freaf87/FSEDevBoard/README.md

Rpi Autonomous Car PCB 
====================
This board bring those additional functions below to the Raspberry pi:

	 - Analog Digital Converter with MCP3008 (8)
	 - DC Brushed Motor driver (2) with TB6612FNG
	 - Level converted IOs (5V <-> 3.3V) (8)
     - 16-channel, 12-bit PWM with PCA9685
     - RGB LED (1)
     - Pushbutton (1)

Top                                                                      |  Bottom
:-----------------------------------------------------------------------:|:--------------------------------------------------------------:
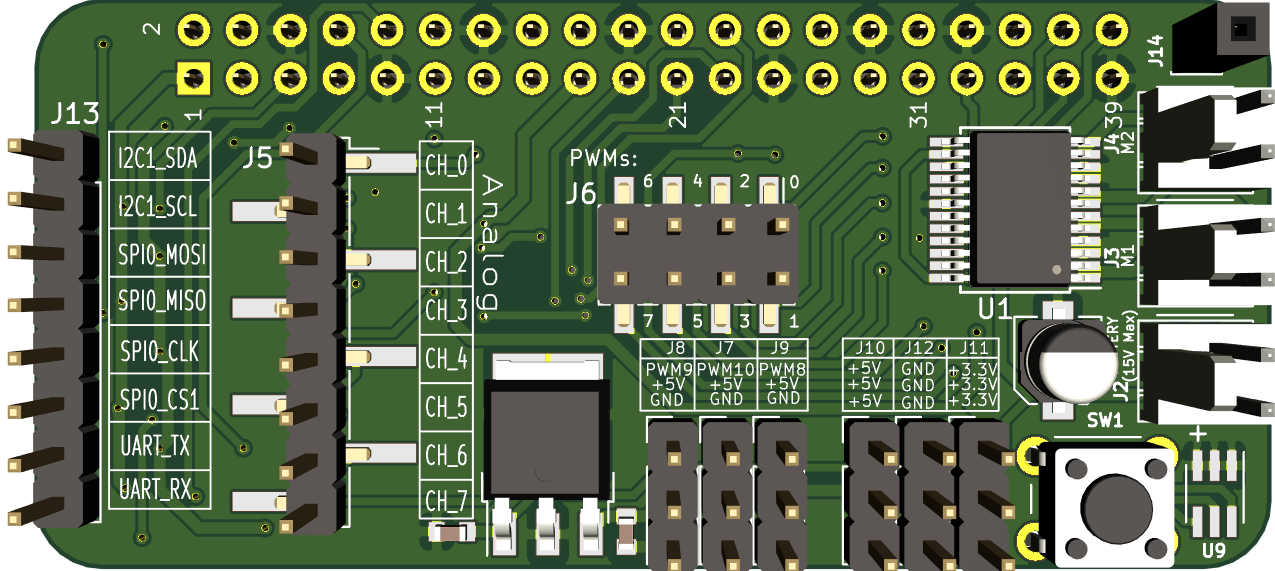
[picture p1: 03_Docs/Documentation/Figures/topView.png]
Top
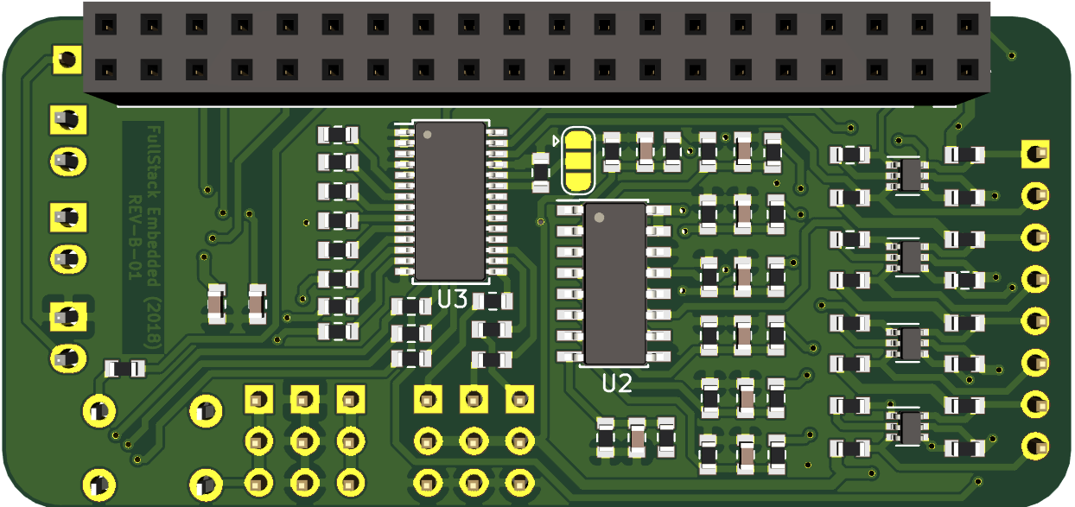
[picture p2: 03_Docs/Documentation/Figures/bottomView.png]
Bottom
  |  

Author: Frederic Afadjigla, 2018
