freaf87/FSEDevBoard/03_Docs/Documentation/FSEDevBoardDoc.pdf

# F S E D E V E L O PM E N T B O A R D

# R E F E R E N C E M A N U A L

frederic afadjigla

Decembre 22, 2018

contents

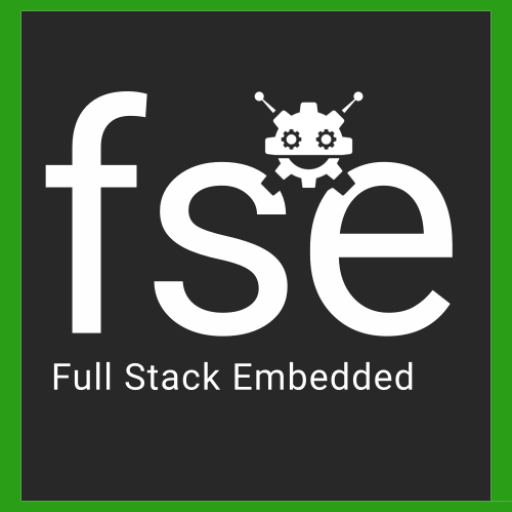
[picture p9: figure]

1 | Introduction | 3
2 | FSEDevBoard and its Components | 3
2.1 | Analog Inputs for Raspberry Pi Using the MCP3008 | | 4
2.2 | Level Converted Pins | | 5
2.3 | DC Motor driver - TB6612FNG | | 6
3 | The Raspberry Pi pinout | 7
Appendices | 8

list of figures

Figure 1 | Top view of board | | 3
Figure 2 | Bottom view of board | | 3
Figure 3 | FSEDevBoard Overview | | 3
Figure 4 | MCP3008 schematic | | 4
Figure 5 | Level Converter | | 5
Figure 6 | TB6612FNG schematic | | 6
Figure 7 | RPiZero | | 8

list of tables

Table 1 | MCP3008 SPI connection | | 4
Table 2 | Level Converted Pins | | 5

1

List of Tables 2

abstract

The purpose of this document is to give the reader an overview about the FSEDevBoard’s hardware. This plattform will be use during FSE workshops. Principal hardware components of the board and interfaces will be briefly described.

introduction | 3
1 | introduction

This breakout board was build with the intention to add some additional features to the Raspberry Pi such as 8 Analog Digital Converter Pins, 2 DC Brushed Motor driver interfaces with TB6612FNG, 8 bidirectional level converted IOs (5V <-> 3.3V), 16-channel 12-bit PWM with PCA9685, one RGB LED and one Pushbutton. The following chapter will bring some light in how to interact with those functionalities.

2 fsedevboard and its components

Top and bottom view of the board are shown in figure 1 and figure 2. Brief Overview of the board can be taken from figure 3. All Jumpers are placed on the top to ease connection with jumper wires. Powering the board and the Pi can done via the micro USB port of the Raspberry Pi or via the Jumper J2. Please make sure not to connect both at the same time or this will destroy both boards. A battery voltage of maximum 15V can be connected to that jumper. This voltage will be used to drive both DC Motors and will be break down to 5V via a linear voltage regulator and provided to the Raspberry Pi.

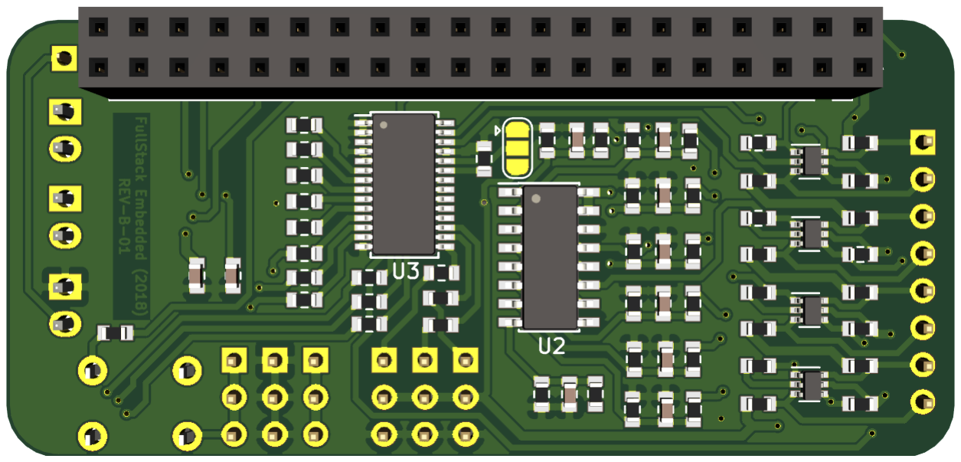
[picture p10: figure]
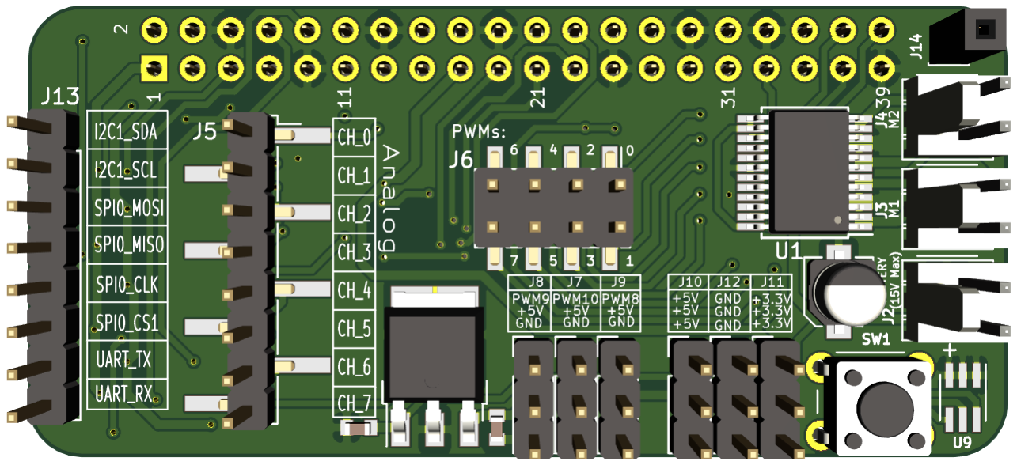
[picture p11: figure]

Figure 1: Top view of board | Figure 2: Bottom view of board

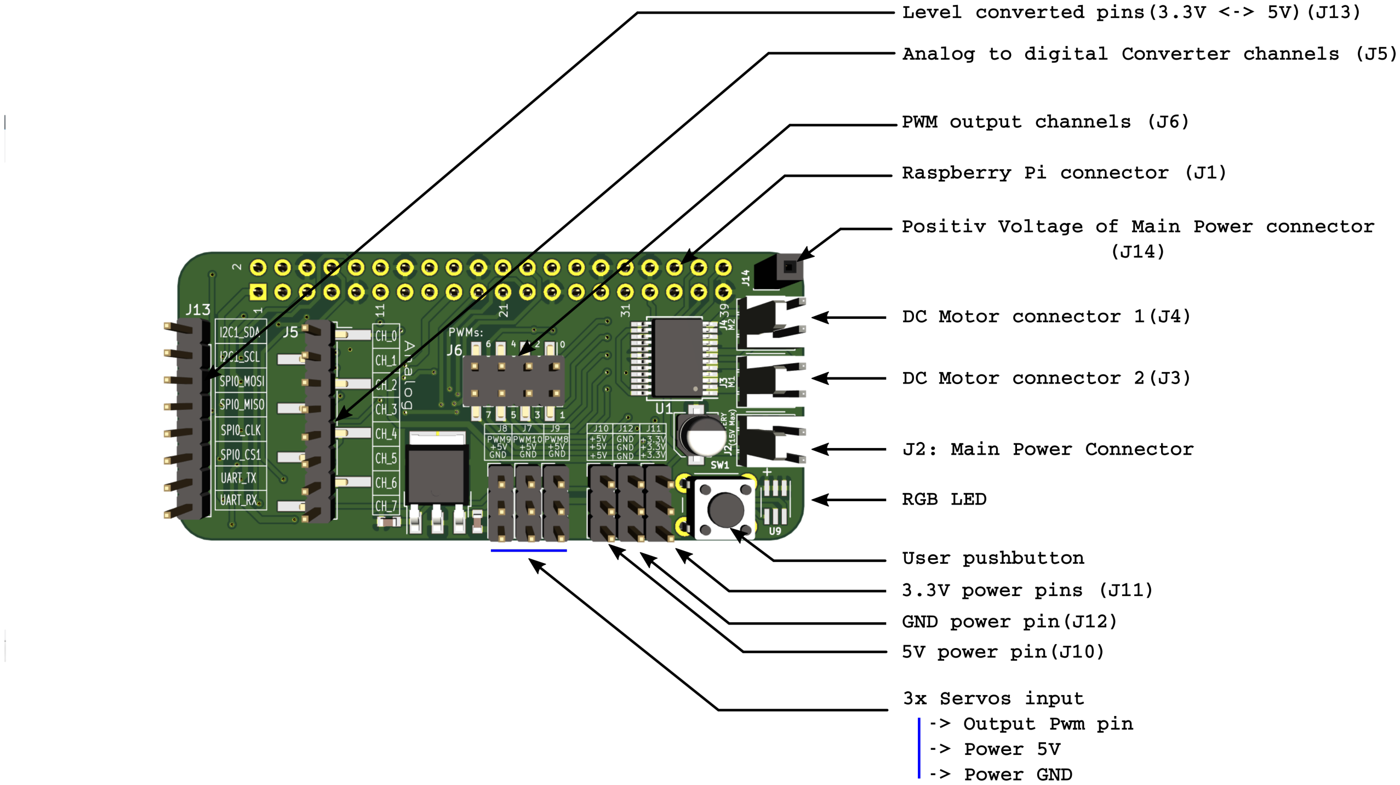
[picture p12: figure]

Figure 3: FSEDevBoard Overview

fsedevboard and its components | 4
2.1 | Analog Inputs for Raspberry Pi Using the MCP3008

The MCP3008 is a low cost 8-channel 10-bit analog to digital converter. The MCP3008 connects to the Raspberry Pi using a serial peripheral interface (SPI) serial connection.

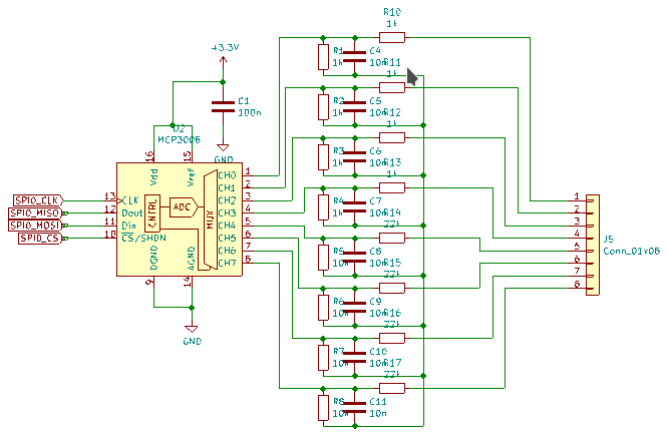
[picture p13: figure]

Figure 4: MCP3008 schematic

SPI Pins | Raspberry Pi pin
SCLK (Serial Clock) | GPIO11
MOSI (Master Out Slave In) | GPIO10
MISO (Master In Slave Out) | GPIO09
CS (Chip Select) | GPIO25

Table 1: MCP3008 SPI connection

Voltage that are allowed to be connected to the MCP3008 have to be selected so that Vout muss be less than 3.3V(Vref). Vout is the voltage that can be measured after the voltage dividers. All 4 first channels (0,1,2 and 3) are designed to have a measuring range of 0-5V DC. The last 4 Channels can measure up to 10V. Vout[0−3]

| for channels 0,1,2 and
3 can be calculated as:

Vout[0−3] =

R6
R5 + R6

∗ Vin = 0.5 ∗ Vin

In case of channel 4,5,6 and 7:

Vout[4−7] = 0.316 ∗ Vin

Jumper J14 can be connected to one of Channel 4 to 7 to measure the batterie voltage of the Board.

fsedevboard and its components | 5
2.2 | Level Converted Pins

Precautions have to be taken when connecting 5V devices to the raspberry pi since the Pi is not 5V tolerant. The user has to make sure that voltage going to the Raspberry Pi do not exceed 5V. There are many ways to handle the matter. Easiest way is probably using voltage dividers with 2 resistors. Care has to be taken to the direction of the voltage since those are not bidirectional. More robust way which gives you biderctional capacity is by using an Integrated circuit (IC) or using the circuitry like I did in figure 5 based on one N-Channel Mosfet.

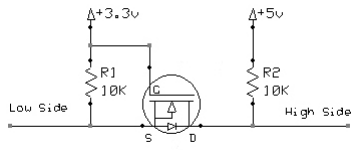
[picture p14: figure]

Figure 5: Level Converter 1

Low Side Control: When the low side (3.3V) device transmits a ’1’ (3.3V), the MOSFET is tied high (off), and the high side sees 5V through the R2 pull-up resistor. When the low side transmits a ’0’ (0V), the MOSFET source pin is grounded and the MOSFET is switched on and the high side is pulled down to 0V.²
High Side Control: When the high side transmits a ’0’ (0V) the MOSFET substrate diode conducts pulling the lowside down to approx 0.7V, this is also low enough to turn the MOSFET on, further pulling the low side down. When the high side transmits a ’1’ (5V) the MOSFET source pin is pulled up to 3.3V and the MOSFET is OFF.
Note This works with I2C and other open collector type gates 3
Pins | RPi pin
1 | GPIO02
2 | GPIO03
3 | GPIO10
4 | GPIO09
5 | GPIO011
6 | GPIO07
7 | GPIO14
8 | GPIO15

Table 2: Level Converted Pins

1 http://www.hobbytronics.co.uk/mosfet-voltage-level-converter
2 see footnote 1
3 see footnote 1

fsedevboard and its components | 6
2.3 | DC Motor driver - TB6612FNG

The TB6612FNG motor driver can control up to two DC motors at a constant current of 1.2A (3.2A peak). Two input signals (IN1 and IN2) can be used to control the motor in one of four function modes - clockwise (CW), counter-clockwise (CCW), short-brake, and stop. The two motor outputs (A and B) can be separately controlled, the speed of each motor is controlled via a PWM input signal with a frequency up to 100kHz. The STBY pin should be pulled high to take the motor out of standby mode.
Logic supply voltage (VCC) can be in the range of 2.7-5.5VDC, while the motor supply (VM) is limited to a maximum voltage of 15VDC. The output current is rated up to 1.2A per channel (or up to 3.2A for a short, single pulse).

Features:
- Power supply voltage: VM=15V max, VCC=2.7-5.5V
- Output current: Iout=1.2A(average) / 3.2A (peak)
- Standby control to save power
- CW/CCW/short brake/stop motor control modes
- Built-in thermal shutdown circuit and low voltage detecting circuit
- All pins of the TB6612FNG broken out to 0.1" spaced pins
- Filtering capacitors on both supply lines


Figure 6: TB6612FNG schematic

the raspberry pi pinout | 7

Let’s discuss the pinout for the TB6612FNG:

Pin Label | Function | Notes
VM | Motor Voltage | This is where you provide power for the motors (2.2V to
13.5V)
VCC | Logic Voltage | This is the voltage to power the chip and talk to the micro-
controller (2.7V to 5.5V)
GND | Ground | Common Ground for both motor voltage and logic voltage
(all GND pins are connected)
STBY | Standby | Allows the H-bridges to work when high (has a pulldown
resistor so it must actively pulled high)
AIN1/BIN1 | Input 1 for channels A/B | One of the two inputs that determines the direction
AIN2/BIN2 | Input 2 for channels A/B | One of the two inputs that determines the direction
PWMA/PWMB | PWM input for channels
A/B

PWM input that controls the speed

A01/B01 | Output 1 for channels A/B | One of the two outputs to connect the motor
A02/B02 | Output 2 for channels A/B | One of the two outputs to connect the motor

Table 3: TB6612FNG connection

When the outputs are set to High/Low your motor will run. When they are set to Low/High the motor will run in the opposite direction. In both cases, the speed is controlled by the PWM input.

In1 | In2 | PWM | Out1 | Out2 | Mode
H | H | H/L | L | L | Short brake
L | H | H | L | H | CCW
L | H | L | L | L | Short brake
H | L | H | H | L | CW
H | L | L | L | L | Short brake
L | L | H | OFF | OFF | Stop

Table 4: TB6612FNG Logic

3 the raspberry pi pinout

The Raspberry Pi is a credit card-sized minicomputer with a pre-installed Linux system. As for ports, the Raspberry Pi provides ports for mouse and keyboard. In addition, there are also ports for SD card and HDMI display. Being low cost and low consumption, the Raspberry Pi is very suitable to do very complicated embedded projects through its powerful GPIO (General-purpose input/output) pins. The Raspberry Pi’s GPIOs can be accessed over a standard male header on the board. Over the years the header expanded from 26 to 40 pins.There are 2 different numbering schemes you may encounter when referencing Pi pin numbers: (1) Broadcom chip-specific pin numbers and (2) P1 physical pin numbers. You’re usually free to use either number-system, but many programs require that you declare which scheme you’re using at the very beginning of your program. The Official name of a GPIO pin normally matches BCM pin number. For example, Physical Pin 7 (described in Table 5 ’s column Pin Nbr) official name is GPIO 04 , in BCM system is pin# 4.
Green areas in Table 5 are representing free GPIOs which are not connected to anything on the FSEDevBoard. Therefore, you can safely add some new connections to those pins

8

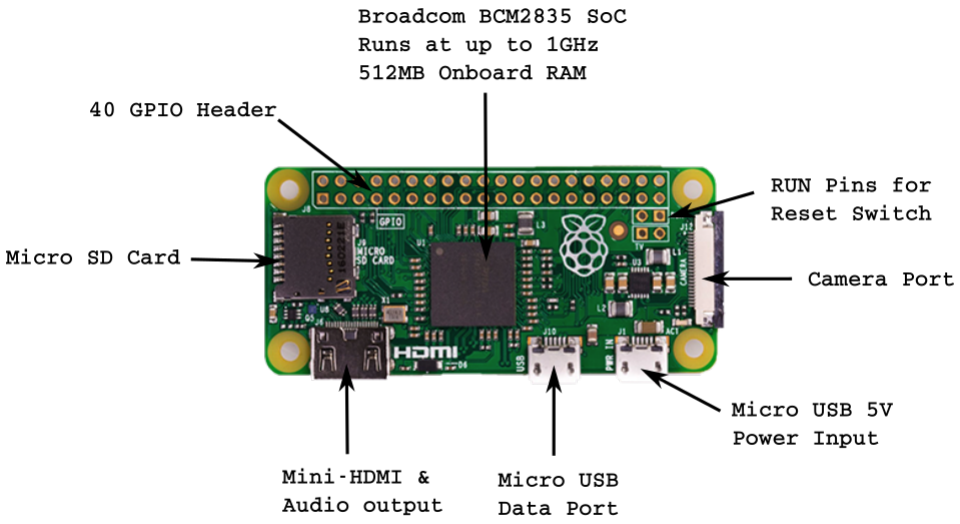
[picture p15: figure]

Figure 7: RPiZero

FSEDevBoard | Name | Pin Nbr | Name | FSEDevBoard
| 3V3 | 1 | 2 | 5V
LV I2C1 SDA | GPIO02 (SDA1, I2C) | 3 | 4 | 5V
LV I2C1 SCL | GPIO03 (SCL1, I2C) | 5 | 6 | GND
| GPIO04 (GPIO_GCLK) | 7 | 8 | GPIO14 (TXD0) | LV UART TX
| GND | 9 | 10 | GPIO15 (RXD0) | LV UART RX
| GPIO17 (GPIO_GEN0) | 11 | 12 | GPIO18 (GPIO_GEN1)
| GPIO27 (GPIO_GEN2) | 13 | 14 | GND
| GPIO22 (GPIO_GEN3) | 15 | 16 | GPIO23 (GPIO_GEN4)
| 3V3 | 17 | 18 | GPIO24 (GPIO_GEN5)
LV SPI0 MOSI | GPIO10 (SPI_MOSI) | 19 | 20 | GND
LV SPI0 MISO | GPIO09 (SPI_MISO) | 21 | 22 | GPIO25 (GPIO_GEN6) | Push button
LV SPI0 CLK | GPIO11 (SPI_CLK) | 23 | 24 | GPIO08 (SPI_CE0_N) | MCP3008 SPI0 CS
| GND | 25 | 26 | GPIO07 (SPI_CE1_N) | LV SPI0 CS1 (J13_6)
| ID_SD (I2C ID EEPROM) | 27 | 28 | ID_SC (I2C ID EEPROM)
| GPIO05 | 29 | 30 | GND
| GPIO06 | 31 | 32 | GPIO12 | TB6612FNG PWMA
TB6612FNG PWMB | GPIO13 | 33 | 34 | GND
TB6612FNG AIN1 | GPIO19 | 35 | 36 | GPIO16 | TB6612FNG AIN2
TB6612FNG BIN1 | GPIO26 | 37 | 38 | GPIO20 | TB6612FNG BIN2
| GND | 39 | 40 | GPIO21 | TB6612FNG STBY

Table 5: Raspberry Pi Pinout

# Appendices

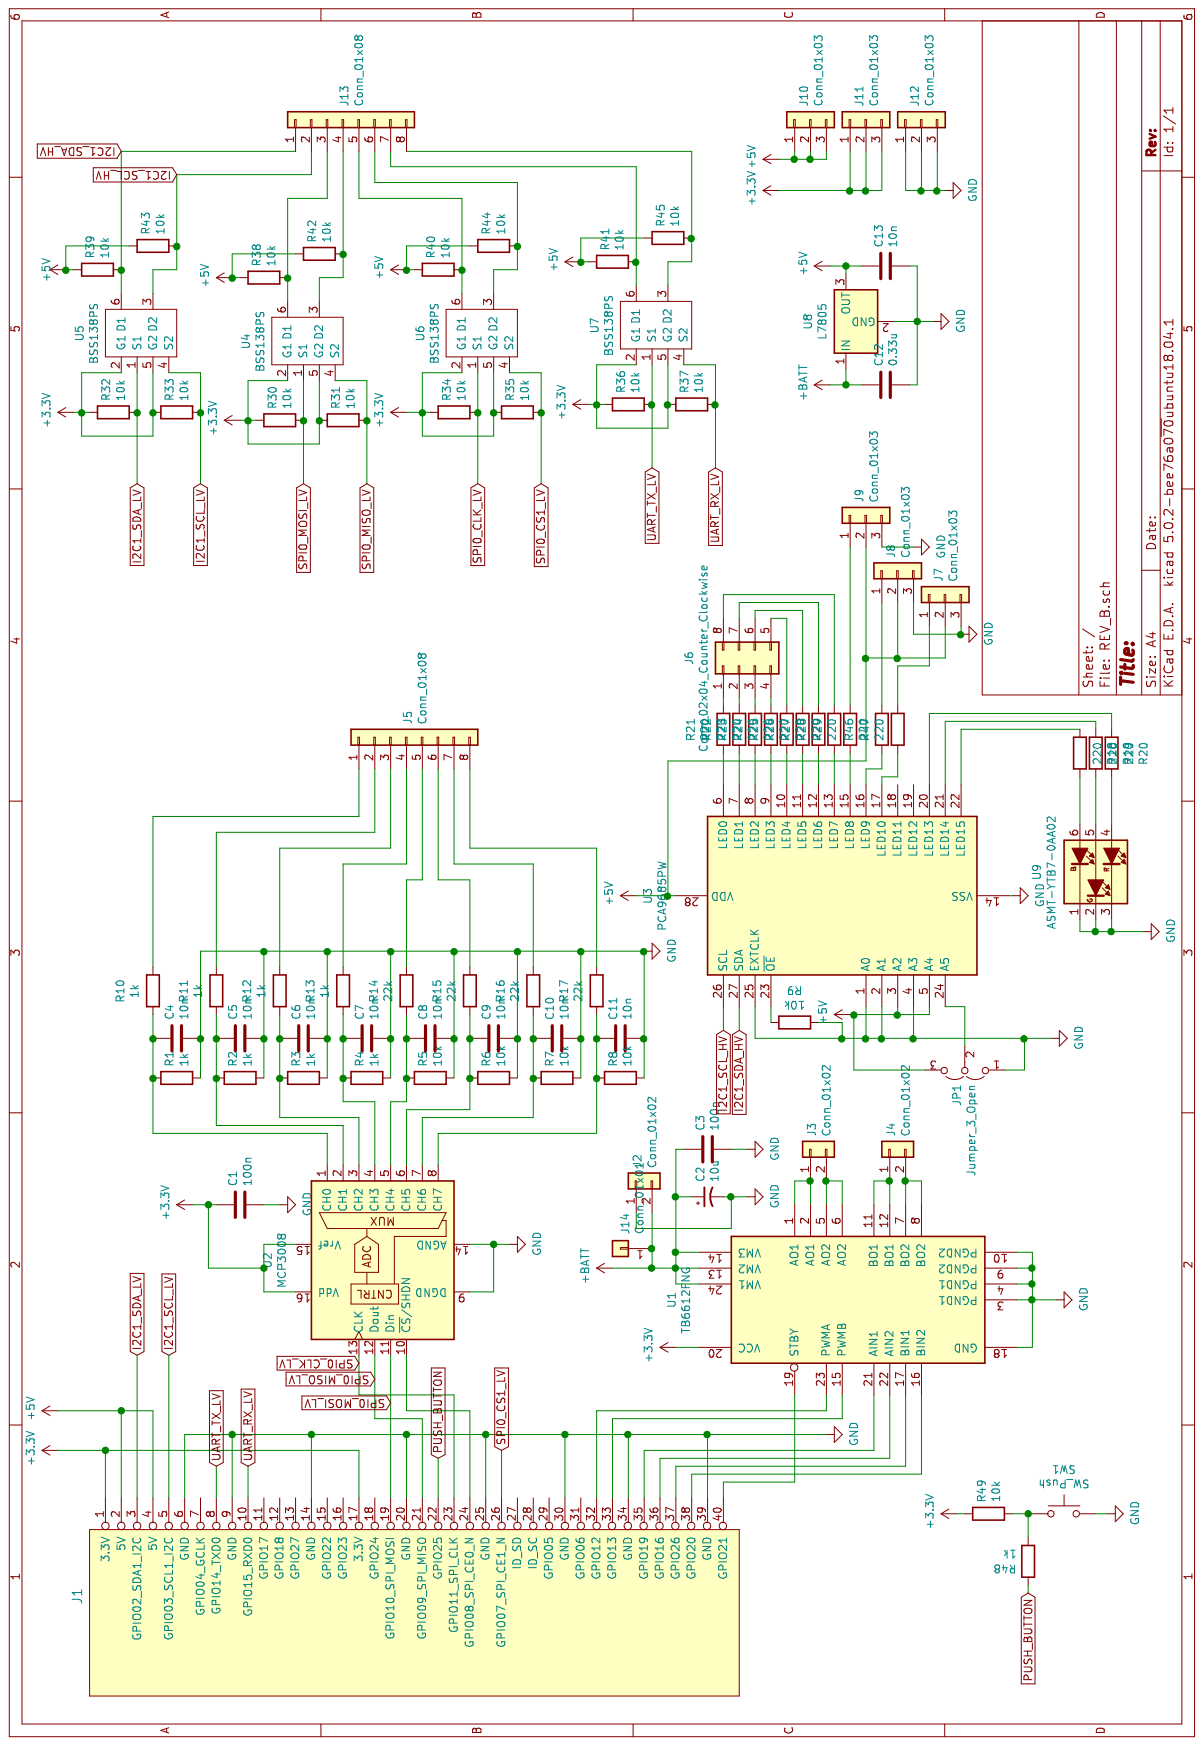
[picture p16: page 9]
