freaf87/FSEDevBoard/03_Docs/Documentation/Figures/LevelConverter.png

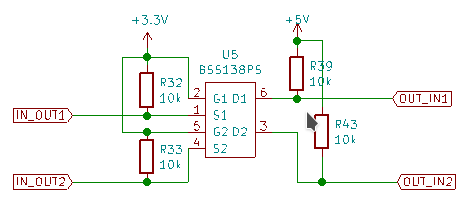
03_Docs/Documentation/Figures/LevelConverter.png
