freaf87/FSEDevBoard/03_Docs/Documentation/Figures/PCA9685.png

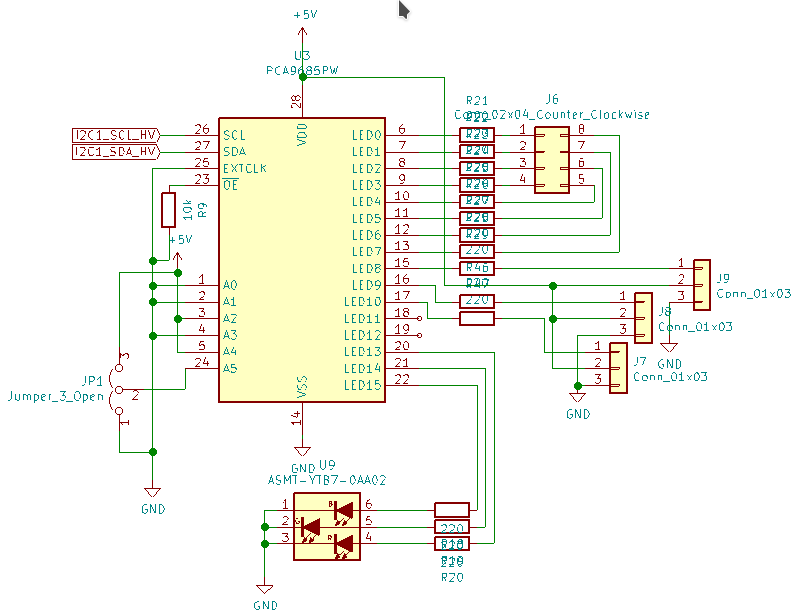
03_Docs/Documentation/Figures/PCA9685.png
