freaf87/FSEDevBoard/03_Docs/Documentation/Figures/PushButton.png

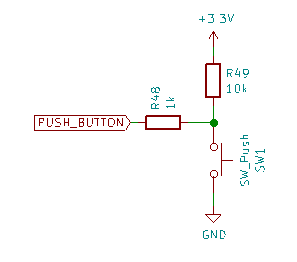
03_Docs/Documentation/Figures/PushButton.png
