freaf87/FSEDevBoard/03_Docs/Documentation/Figures/RaspberryPiZero.png

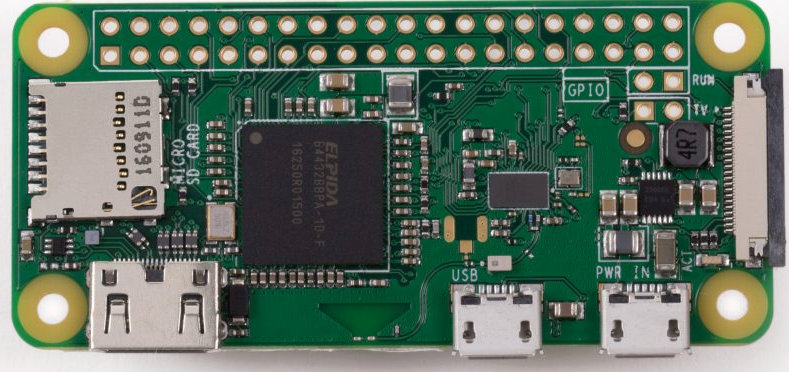
03_Docs/Documentation/Figures/RaspberryPiZero.png
