freaf87/FSEDevBoard/04_Order/REV_B_Order.ods

Sheet: ORDER
DATE: 12.12.2018
DIGIKEY ORDER
 | Pos | Menge | Teilenummer | Hersteller-Teilenummer | Beschreibung | Kundenreferenz | Stückpreis | Gesamtpreis EUR
 | 1 | 1 | 516-3132-1-ND | ASMT-YTB7-0AA02 | LED RGB DIFFUSED 6PLCC SMD | U9 | 1,17000 | 1,17
 | 2 | 2 | 1276-1012-1-ND | CL10F104ZB8NNNC | CAP CER 0.1UF 50V Y5V 0603 | C1, C3 | 0,09000 | 0,18
 | 3 | 1 | PCE3878CT-ND | EEE-1CA100SR | CAP ALUM 10UF 20% 16V SMD | C2 | 0,27000 | 0,27
 | 4 | 10 | 478-9371-1-ND | 06031C103K4T2A | CAP CER 10000PF 100V X7R 0603 | C4, C5, C6, C7, C8, C9, C10, C11, C13 | 0,08700 | 0,87
 | 5 | 1 | 311-2081-1-ND | CC0603KRX7R7BB334 | CAP CER 0.33UF 16V X7R 0603 | C12 | 0,18000 | 0,18
 | 6 | 1 | S1013EC-16-ND | NREC016SABC-M30RC | CONN HEADER .100" SNGL SMD 16POS |  | 0,47000 | 0,47
 | 7 | 1 | 952-3158-ND | M20-8750442 | CONN HDR .100" SMD 8POS |  | 0,56000 | 0,56
 | 8 | 10 | RR08P1.0KDCT-ND | RR0816P-102-D | RES SMD 1K OHM 0.5% 1/16W 0603 | R1, R2, R3, R4, R10, R11, R12, R13, R48 | 0,08600 | 0,86
 | 9 | 25 | RR08P10.0KDCT-ND | RR0816P-103-D | RES SMD 10K OHM 0.5% 1/16W 0603 | R5, R6, R7, R8, R9, R30, R31, R32, R33, R34, R35 | 0,08600 | 2,15
 | 10 | 5 | RHM22KDCT-ND | ESR03EZPJ223 | RES SMD 22K OHM 5% 1/4W 0603 | R14, R15, R16, R17 | 0,09000 | 0,45
 | 11 | 15 | RHM220DCT-ND | ESR03EZPJ221 | RES SMD 220 OHM 5% 1/4W 0603 | R18, R19, R20, R21, R22, R23, R24, R25, R26, R27 | 0,07600 | 1,14
 | 12 | 1 | 450-1650-ND | 1825910-6 | SWITCH TACTILE SPST-NO 0.05A 24V | SW1 | 0,09000 | 0,09
 | 13 | 1 | TB6612FNGC8ELCT-ND | TB6612FNG,C,8,EL | IC MOTOR DRIVER PAR 24SSOP | U1 | 1,85000 | 1,85
 | 14 | 1 | MCP3008T-I/SLCT-ND | MCP3008T-I/SL | IC ADC 10BIT 2.7V 8CH SPI 16SOIC | U2 | 1,98000 | 1,98
 | 15 | 1 | 568-8366-5-ND | PCA9685PW,112 | IC LED DRVR LIN DIM 25MA 28TSSOP | U3 | 1,98000 | 1,98
 | 16 | 4 | 1727-6478-1-ND | BSS138BKS,115 | MOSFET 2N-CH 60V 0.32A 6TSSOP | U4, U5, U6, U7 | 0,44000 | 1,76
 | 17 | 1 | 497-7255-1-ND | L7805CDT-TR | IC REG LINEAR 5V 1.5A DPAK | U8 | 0,66000 | 0,66
REICHELT ORDER

Sheet: Sheet2
 | www.digikey.com
 | www.reichelt.de
 | Description | References | Value | Quantity | Prize | Total | Link
1 | Unpolarized capacitor | C12 | 0.33u | 1 | 0.1 | 0.1 | 311-2081-1-ND
2 | Unpolarized capacitor | C1 C3 | 100n | 2 | 0.132 | 0.264 | 445-12576-1-ND
3 | Unpolarized capacitor | C4 C5 C6 C7 C8 C9 C10 C11 C13 | 10n | 9 | 0.058 | 0.522 | 445-5662-1-ND
4 | Polarised capacitor | C2 | 10u | 1 | 0.24 | 0.24 | PCE3878CT-ND
5 | LED RGB, common anode (pin 1) | D1 | LED_ARGB | 1 | 0.47 | 0.47 | 516-3279-1-ND
6 | Generic connector, single row, 01x02 male | J2 J3 J4 | Conn_01x02 | 3 | 0.03 | 0.09 | PSS 254/2G
7 | Generic connector, single row, 01x02 female | J2 J3 J4 |  | 3 | 0.01 | 0.03 | PSK 254/2W
8 | Crimpkontakte für psk 254/ | J2 J3 J4 |  | 3 | 0.3 | 0.9 | PSK-KONTAKTE
9 | Generic connector, single row, 01x03, script generated (kicad-library-utils/schlib/autogen/connector/) | J7 J8 J9 J10 J11 J12 | Conn_01x03 | 6 | 0.0174 | 0.1044 | MPE 087-1-050
10 | Generic connector, single row, 01x08, script generated (kicad-library-utils/schlib/autogen/connector/) | J13 | Conn_01x08 | 1 | 0.1392 | 0.1392 | MPE 087-1-050
11 | Generic connector, single row, 01x08, script generated (kicad-library-utils/schlib/autogen/connector/) | J5 | Conn_01x08 | 1 | 0.46 | 0.46 | S1013EC-16-ND
12 | Generic connector, double row, 02x04, counter clockwise pin numbering scheme (similar to DIP packge numbering), script generated (kicad-library-utils/schlib/autogen/connector/) | J6 | Conn_02x04_Counter_Clockwise | 1 | 0.58 | 0.58 | SAM10794-ND
13 | Raspberry Pi | J1 | RaspberryPi | 1 |  | 0
14 | Resistor | R5 R6 R7 R8 R9 R30 R31 R32 R33 R34 R35 R36 R37 R38 R39 R40 R41 R42 R43 R44 R45 | 10k | 21 | 0.0321 | 0.6741 | RR08P10.0KDCT-ND
15 | Resistor | R1 R2 R3 R4 R10 R11 R12 R13 R48 | 1k | 9 | 0.0321 | 0.2889 | RR08P1.0KDCT-ND
16 | Resistor | R18 R19 R20 R21 R22 R23 R24 R25 R26 R27 R28 R29 R46 R47 | 220 | 14 | 0.0284 | 0.3976 | RHM220DCT-ND
17 | Resistor | R14 R15 R16 R17 | 22k | 4 | 0.0284 | 0.1136 | RHM22KDCT-ND
18 | Push button switch, generic, two pins | SW1 | SW_Push | 1 | 0.26 | 0.26 | P16765CT-ND
19 | MOSFET 2N-CH 60V 0.32A 6TSSOP | U4 U5 U6 U7 | BSS138PS | 4 | 0.64 | 2.56 | 497-7255-1-ND
20 | Positive 1.5A 35V Linear Regulator, Fixed Output 5V, TO-220/TO-263/TO-252 | U8 | L7805 | 1 | 0.64 | 0.64 | 497-7255-1-ND
21 | A/D Converter, 12-Bit, 8-Channel, SPI Interface , 2.7V-5.5V | U2 | MCP3008 | 1 | 1.93 | 1.93 | MCP3008T-I/SLCT-ND
22 | 16-channel 12-bit PWM Fm+ I2C-bus LED controller RGBA TSSOP | U3 | PCA9685PW | 1 | 1.93 | 1.93 | 568-8366-5-ND
23 | Driver IC for Dual DC motor, SSOP-24 | U1 | TB6612FNG | 1 | 1.8 | 1.8 | TB6612FNGC8ELCT-ND
 |  |  |  |  |  | 14.4938
