freaf87/FSEDevBoard/03_Docs/Documentation/Figures/REV_B.pdf

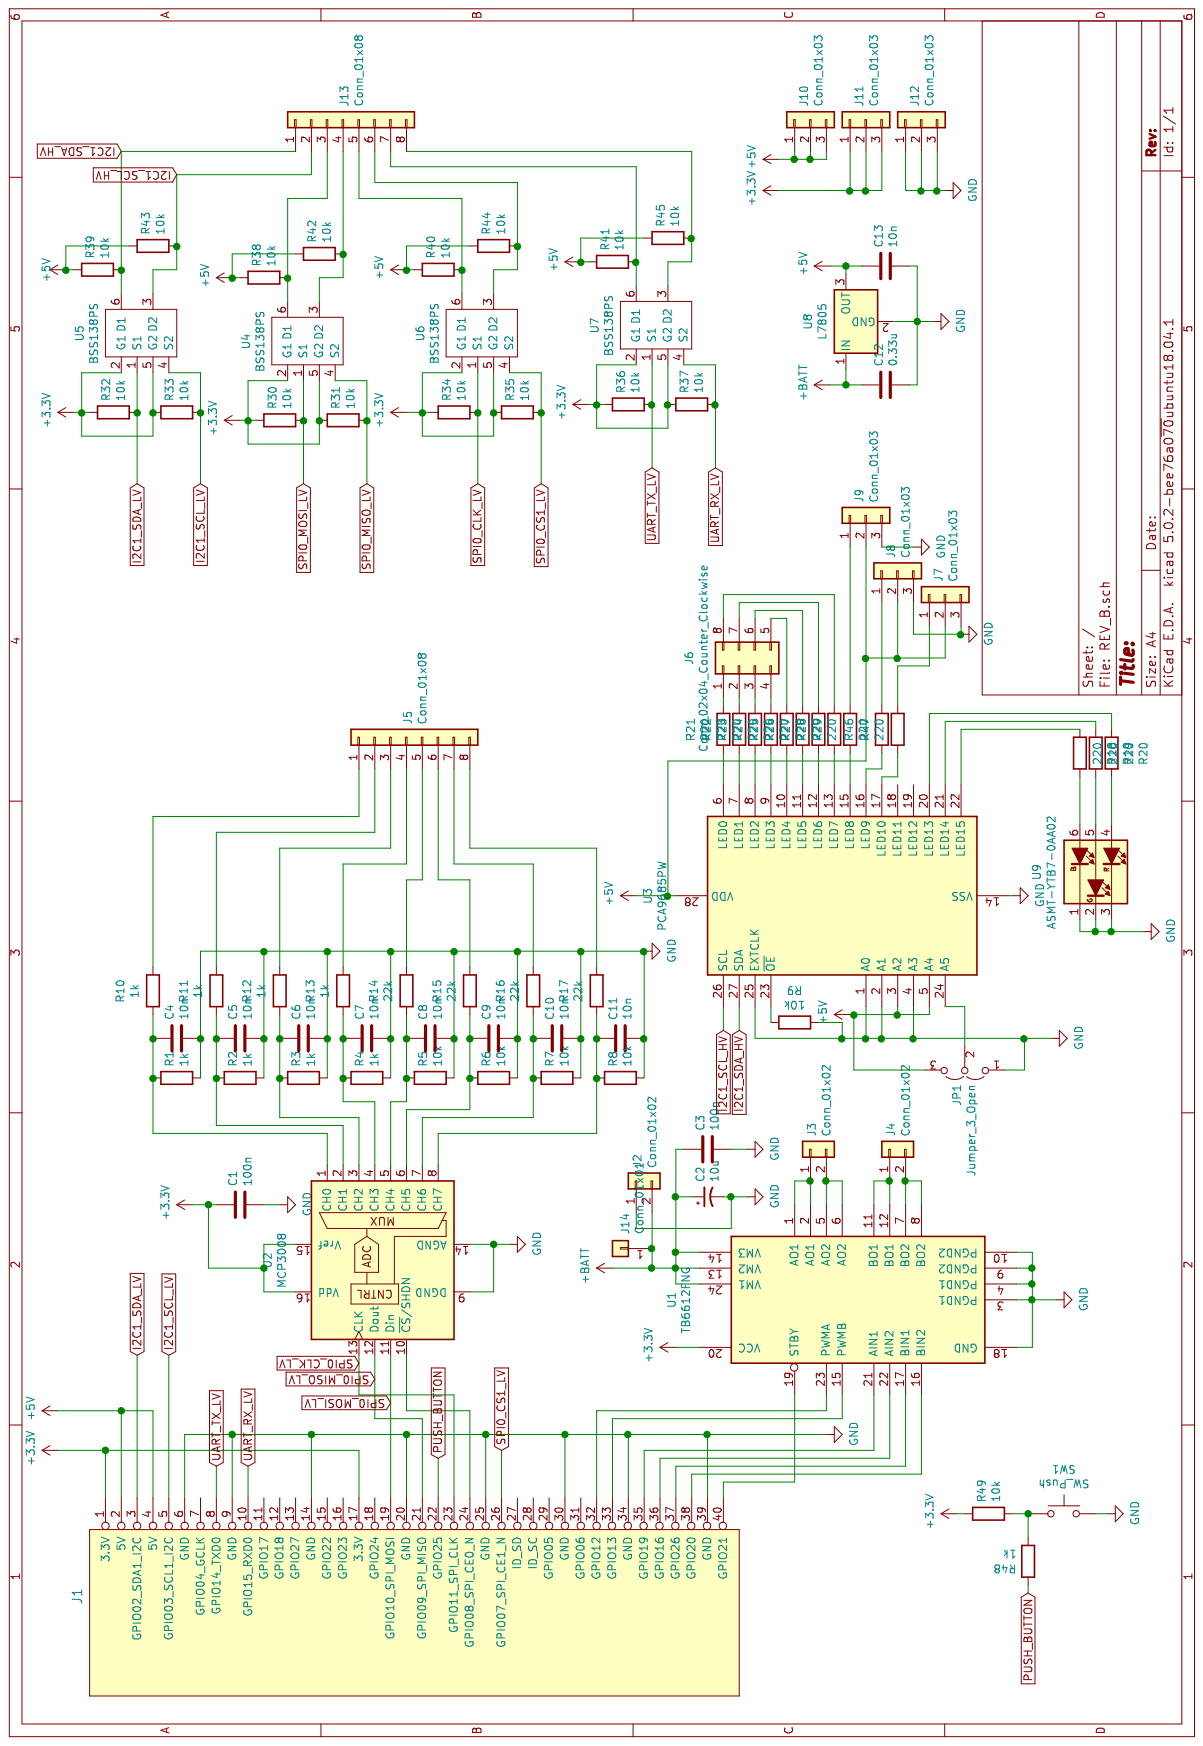
[picture p21: page 1]
