freaf87/FSEDevBoard/01_Hardware/REV_B.kicad_pcb

## KiCad design 01_Hardware/REV_B.kicad_pcb (2018-12-12)

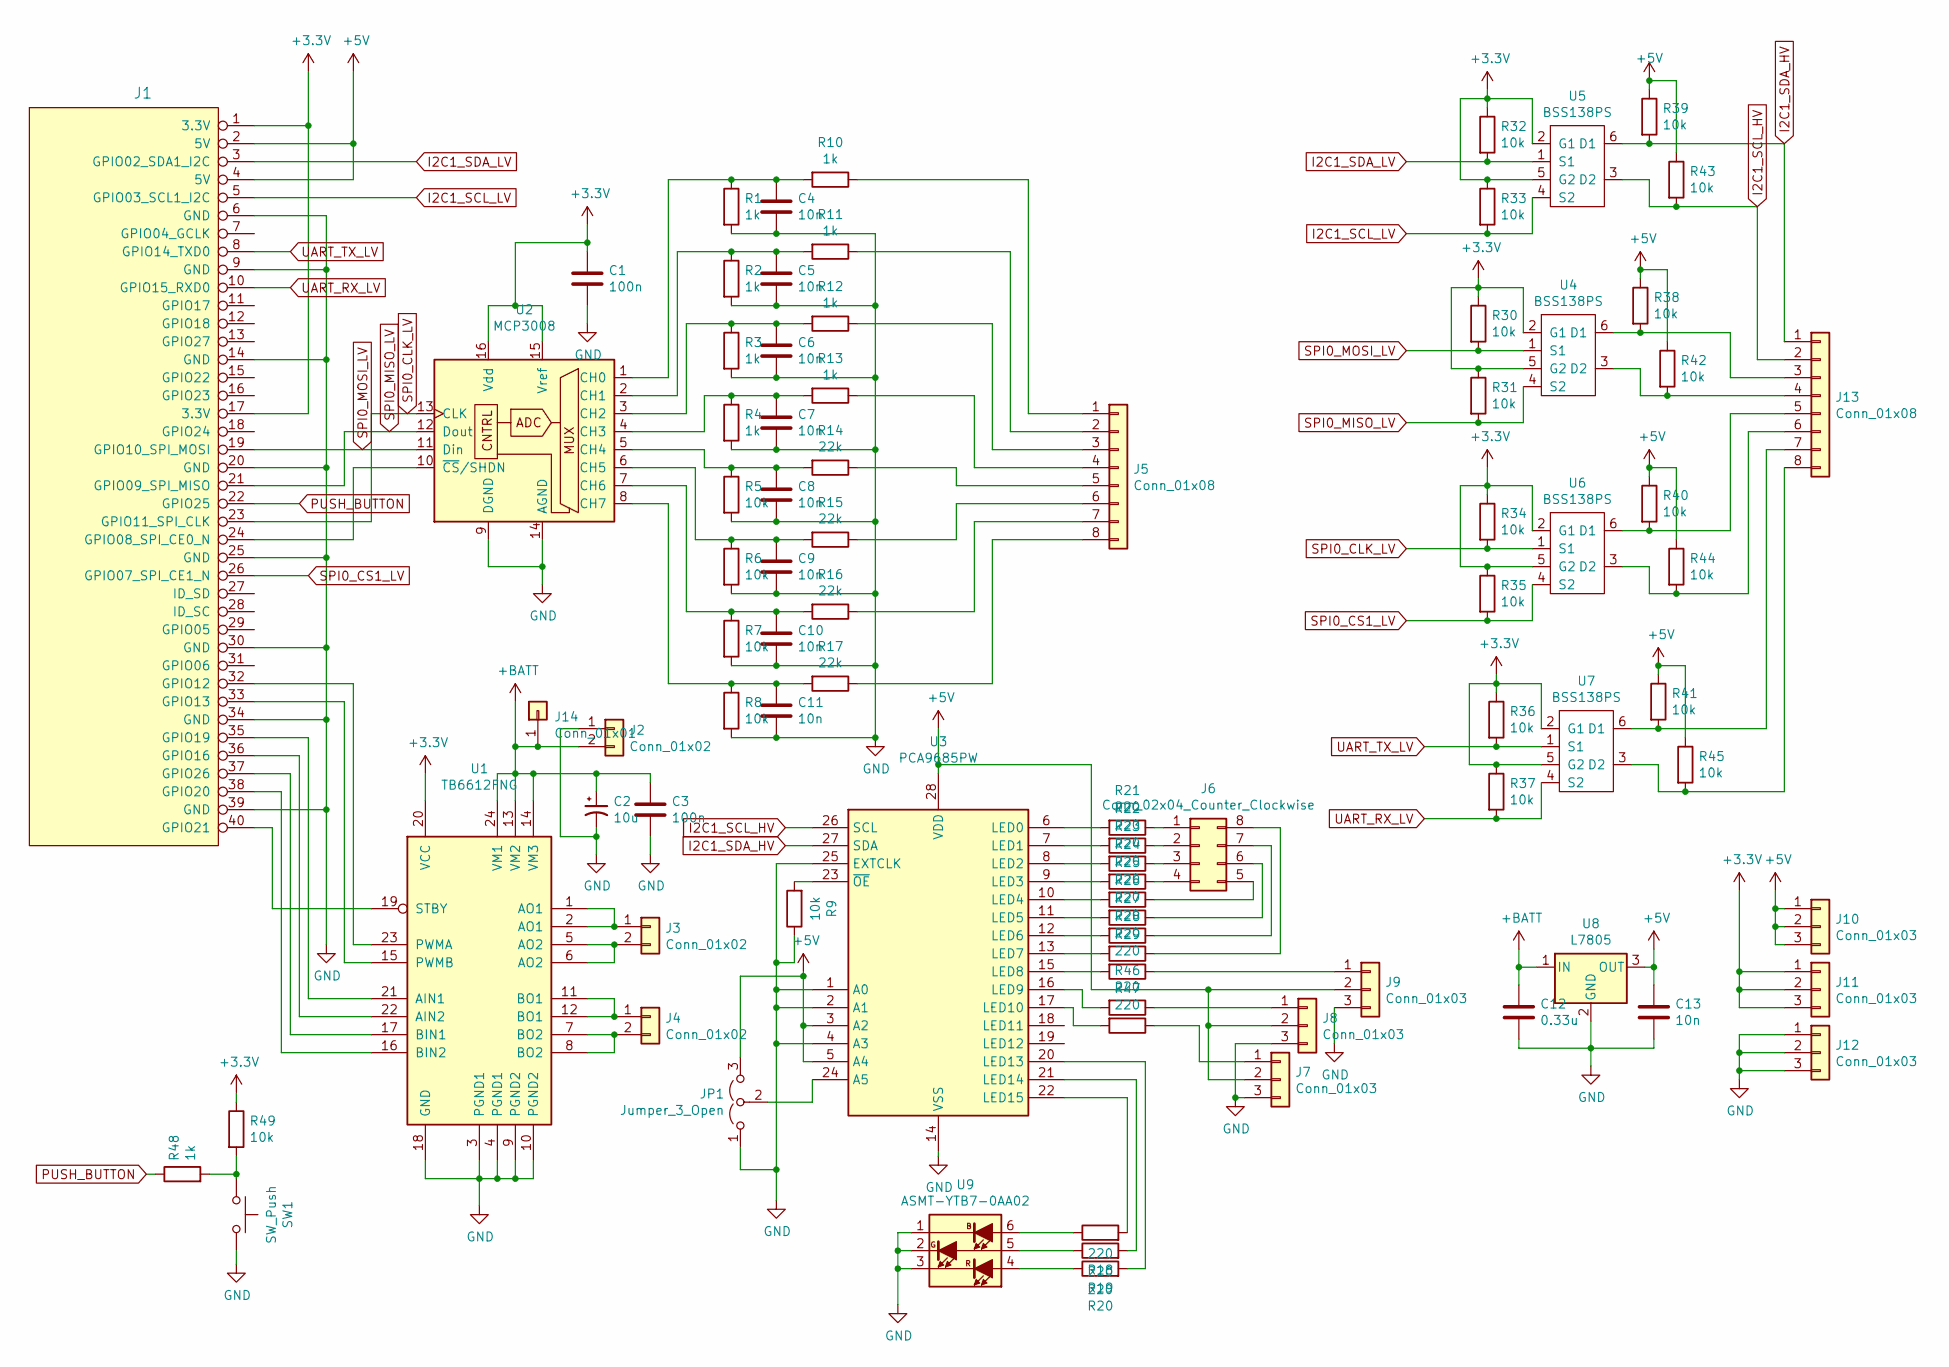
[picture p22: schematic REV_B.sch]

Parts:
C1, C3: 100n; C_0603_1608Metric
C2: 10u; CP_Elec_4x4.5
C4, C5, C6, C7, C8, C9, C10, C11, C13: 10n; C_0603_1608Metric
C12: 0.33u; C_0603_1608Metric
J1: RaspberryPi; PinSocket_2x20_P2.54mm_Vertical
J2, J3, J4: Conn_01x02; Molex_KK-254_AE-6410-02A_1x02_P2.54mm_Vertical
J5: Conn_01x08; PinHeader_1x08_P2.54mm_LongPad_Vertical_SMD_Pin1Right
J6: Conn_02x04_Counter_Clockwise; PinHeader_2x04_P2.54mm_Vertical_SMD
J7, J8, J9, J10, J11, J12: Conn_01x03; PinHeader_1x03_P2.54mm_Vertical
J13: Conn_01x08; PinHeader_1x08_P2.54mm_Vertical
J14: Conn_01x01; PinSocket_1x01_P2.54mm_Vertical
JP1: Jumper_3_Open; SolderJumper-3_P1.3mm_Open_RoundedPad1.0x1.5mm
R1, R2, R3, R4, R10, R11, R12, R13, R48: 1k; R_0603_1608Metric
R5, R6, R7, R8, R9, R30, R31, R32, R33, R34, R35, R36, R37, R38, R39, R40, R41, R42, R43, R44, R45, R49: 10k; R_0603_1608Metric
R14, R15, R16, R17: 22k; R_0603_1608Metric
R18, R19, R20, R21, R22, R23, R24, R25, R26, R27, R28, R29, R46, R47: 220; R_0603_1608Metric
SW1: SW_Push; SW_PUSH_6mm
U1: TB6612FNG; SSOP-24_5.3x8.2mm_P0.65mm
U2: MCP3008; SOIC-16_3.9x9.9mm_P1.27mm
U3: PCA9685PW; TSSOP-28_4.4x9.7mm_P0.65mm
U4, U5, U6, U7: BSS138PS; SOT-363_SC-70-6
U8: L7805; TO-252-3_TabPin2
U9: ASMT-YTB7-0AA02; LED_Avago_PLCC6_3x2.8mm

Connections:
+3V3: C1.1, J1.1 (3.3V), J1.17 (3.3V), J11.1, J11.2, J11.3, R30.1, R31.1, R32.1, R33.1, R34.1, R35.1, R36.1, R37.1, R49.1, U1.20 (VCC), U2.15 (Vref), U2.16 (Vdd), U4.2 (G1), U4.5 (G2), U5.2 (G1), U5.5 (G2), U6.2 (G1), U6.5 (G2), U7.2 (G1), U7.5 (G2)
+5V: C13.1, J1.2 (5V), J1.4 (5V), J7.2, J8.2, J9.2, J10.1, J10.2, J10.3, JP1.3 (B), R38.1, R39.1, R40.1, R41.1, R42.1, R43.1, R44.1, R45.1, U3.3 (A2), U3.5 (A4), U3.28 (VDD), U8.3 (OUT)
+BATT: C2.1, C3.1, C12.1, J2.2, J14.1, U1.13 (VM2), U1.14 (VM3), U1.24 (VM1), U8.1 (IN)
GND: C1.2, C2.2, C3.2, C4.2, C5.2, C6.2, C7.2, C8.2, C9.2, C10.2, C11.2, C12.2, C13.2, J1.6 (GND), J1.9 (GND), J1.14 (GND), J1.20 (GND), J1.25 (GND), J1.30 (GND), J1.34 (GND), J1.39 (GND), J2.1, J7.3, J8.3, J9.3, J12.1, J12.2, J12.3, JP1.1 (A), R1.2, R2.2, R3.2, R4.2, R5.2, R6.2, R7.2, R8.2, R9.1, SW1.2, U1.3 (PGND1), U1.4 (PGND1), U1.9 (PGND2), U1.10 (PGND2), U1.18 (GND), U2.9 (DGND), U2.14 (AGND), U3.1 (A0), U3.2 (A1), U3.4 (A3), U3.14 (VSS), U3.25 (EXTCLK), U8.2 (GND), U9.1 (KB), U9.2 (KG), U9.3 (KR)
I2C1_SCL_HV: J13.2, R43.2, U3.26 (SCL), U5.3 (D2)
I2C1_SCL_LV: J1.5 (GPIO03_SCL1_I2C), R33.2, U5.4 (S2)
I2C1_SDA_HV: J13.1, R39.2, U3.27 (SDA), U5.6 (D1)
I2C1_SDA_LV: J1.3 (GPIO02_SDA1_I2C), R32.2, U5.1 (S1)
unnamed: C4.1, R1.1, R10.2, U2.1 (CH0)
unnamed: C5.1, R2.1, R11.2, U2.2 (CH1)
unnamed: C6.1, R3.1, R12.2, U2.3 (CH2)
unnamed: C7.1, R4.1, R13.2, U2.4 (CH3)
unnamed: C8.1, R5.1, R14.2, U2.5 (CH4)
unnamed: C9.1, R6.1, R15.2, U2.6 (CH5)
unnamed: C10.1, R7.1, R16.2, U2.7 (CH6)
unnamed: C11.1, R8.1, R17.2, U2.8 (CH7)
unnamed: J1.24 (GPIO08_SPI_CE0_N), U2.10 (~CS~/SHDN)
unnamed: J1.32 (GPIO12), U1.23 (PWMA)
unnamed: J1.33 (GPIO13), U1.15 (PWMB)
unnamed: J1.35 (GPIO19), U1.21 (AIN1)
unnamed: J1.36 (GPIO16), U1.22 (AIN2)
unnamed: J1.37 (GPIO26), U1.17 (BIN1)
unnamed: J1.38 (GPIO20), U1.16 (BIN2)
unnamed: J1.40 (GPIO21), U1.19 (STBY)
unnamed: J3.1, U1.1 (AO1), U1.2 (AO1)
unnamed: J3.2, U1.5 (AO2), U1.6 (AO2)
unnamed: J4.1, U1.11 (BO1), U1.12 (BO1)
unnamed: J4.2, U1.7 (BO2), U1.8 (BO2)
unnamed: J5.1, R10.1
unnamed: J5.2, R11.1
unnamed: J5.3, R12.1
unnamed: J5.4, R13.1
unnamed: J5.5, R14.1
unnamed: J5.6, R15.1
unnamed: J5.7, R16.1
unnamed: J5.8, R17.1
unnamed: J6.1, R21.1
unnamed: J6.2, R22.1
unnamed: J6.3, R23.1
unnamed: J6.4, R24.1
unnamed: J6.5, R25.1
unnamed: J6.6, R26.1
unnamed: J6.7, R27.1
unnamed: J6.8, R28.1
unnamed: J7.1, R47.1
unnamed: J8.1, R46.1
unnamed: J9.1, R29.1
unnamed: J13.3, R38.2, U4.6 (D1)
unnamed: J13.4, R42.2, U4.3 (D2)
unnamed: J13.5, R40.2, U6.6 (D1)
unnamed: J13.6, R44.2, U6.3 (D2)
unnamed: J13.7, R41.2, U7.6 (D1)
unnamed: J13.8, R45.2, U7.3 (D2)
unnamed: JP1.2 (C), U3.24 (A5)
unnamed: R9.2, U3.23 (~OE)
unnamed: R18.1, U9.6 (AB)
unnamed: R18.2, U3.22 (LED15)
unnamed: R19.1, U9.5 (AG)
unnamed: R19.2, U3.21 (LED14)
unnamed: R20.1, U9.4 (AR)
unnamed: R20.2, U3.20 (LED13)
unnamed: R21.2, U3.6 (LED0)
unnamed: R22.2, U3.7 (LED1)
unnamed: R23.2, U3.8 (LED2)
unnamed: R24.2, U3.9 (LED3)
unnamed: R25.2, U3.10 (LED4)
unnamed: R26.2, U3.11 (LED5)
unnamed: R27.2, U3.12 (LED6)
unnamed: R28.2, U3.13 (LED7)
unnamed: R29.2, U3.15 (LED8)
unnamed: R46.2, U3.16 (LED9)
unnamed: R47.2, U3.17 (LED10)
unnamed: R48.2, R49.2, SW1.1
PUSH_BUTTON: J1.22 (GPIO25), R48.1
SPI0_CLK_LV: J1.23 (GPIO11_SPI_CLK), R34.2, U2.13 (CLK), U6.1 (S1)
SPI0_CS1_LV: J1.26 (GPIO07_SPI_CE1_N), R35.2, U6.4 (S2)
SPI0_MISO_LV: J1.21 (GPIO09_SPI_MISO), R31.2, U2.12 (Dout), U4.4 (S2)
SPI0_MOSI_LV: J1.19 (GPIO10_SPI_MOSI), R30.2, U2.11 (Din), U4.1 (S1)
UART_RX_LV: J1.10 (GPIO15_RXD0), R37.2, U7.4 (S2)
UART_TX_LV: J1.8 (GPIO14_TXD0), R36.2, U7.1 (S1)

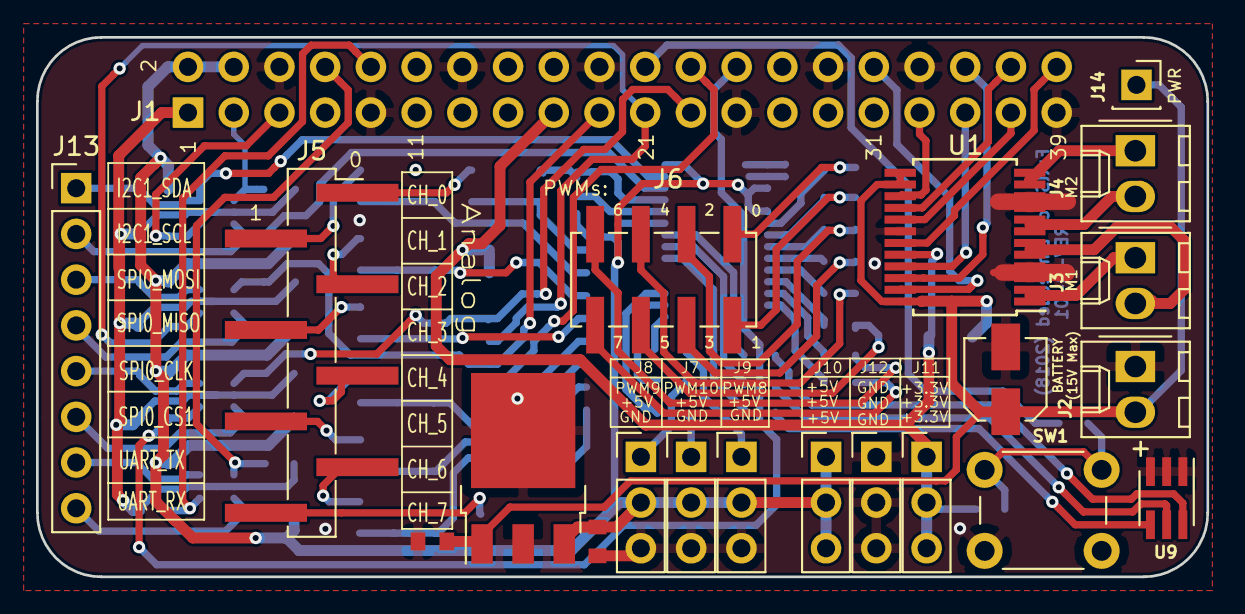
[picture p23: board REV_B.kicad_pcb from above]

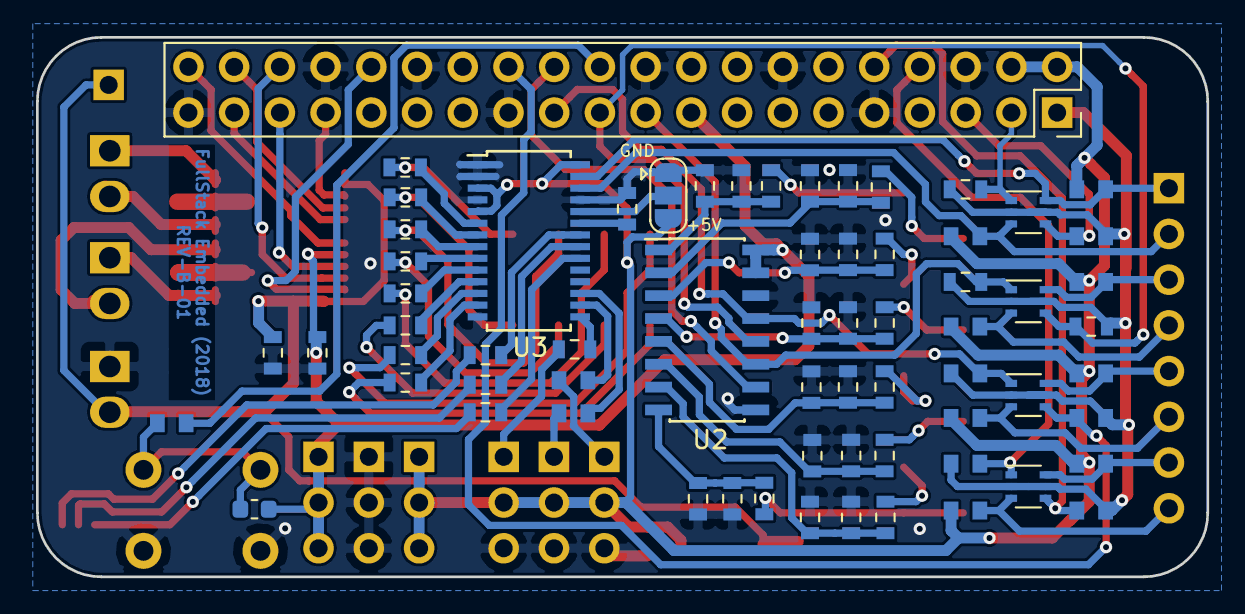
[picture p24: board REV_B.kicad_pcb from below]

Board: 2 copper layers, 65.0 x 30.0 mm, 87 parts (67 on the bottom side), 80 nets.
