freaf87/FSEDevBoard/02_Code/applications/StudentAttendance.py

#!/usr/bin/env python
# -*- coding: utf-8 -*-
# This file is part of FSE 2020.
#
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
import sys
from os.path import dirname
sys.path.append(dirname(__file__))

import time
import wiringpi as wp
from FseDevBoard.rgbLed import RGBLED
from FseDevBoard.buzzer import BUZZER
from FseDevBoard.lcd1602 import LCD1602
from FseDevBoard.rotaryEncoder import ROTARYENCODER

buttonPressed = False

class STUDATTENDANCE(object):
    """ Student Attendance Program """
    def __init__(self):
        self.rgbled = RGBLED()
        self.buzzer = BUZZER(4)
        self.rgbled.pwmDriver.setPwmFreq(600)
        self.lcd = LCD1602(0x27)
        self.rotEnc = ROTARYENCODER()

        wp.wiringPiISR(self.rotEnc.getSWButtonPin(), wp.GPIO.INT_EDGE_FALLING,self.buttonISR)

    def setLEDColor(self, color):
        """ Set RGB color """
        self.rgbled.setRChannelPWM(color[0]/255.0*100)
        self.rgbled.setGChannelPWM(color[1]/255.0*100)
        self.rgbled.setBChannelPWM(color[2]/255.0*100)

    def buttonISR(channel):
        global buttonPressed
        buttonPressed = True
        #print("bottonPressed")

    def __enter__(self):
        return self

    def __exit__(self, *args):
        """Release internally used resources."""
        self.rgbled.__exit__()
        self.buzzer.__exit__()
        self.lcd.__exit__()

if __name__ == "__main__":
    global buttonPressed

    with STUDATTENDANCE() as studAtt:

        studAtt.lcd.clearLcd()
        studAtt.lcd.write(0, 0, 'Welcome')
        studAtt.lcd.write(0, 1, 'Press to start')
        tmpCounter = 0
        while True:
            studAtt.setLEDColor((0, 255, 0))
            studAtt.rotEnc.computeEncoder()
            if (tmpCounter != studAtt.rotEnc.getCounter()):
                studAtt.lcd.write(0, 0, str(studAtt.rotEnc.getCounter()))
                print('counter = ', studAtt.rotEnc.getCounter())
                tmpCounter = studAtt.rotEnc.getCounter()
            if buttonPressed == True:
                buttonPressed = False
                studAtt.lcd.clearLcd()
                studAtt.rotEnc.setCounter(0)
                studAtt.lcd.write(0, 0, str(studAtt.rotEnc.getCounter()))
