freaf87/FSEDevBoard/02_Code/FSEDevBoard/FseDevBoard/mcp3008.py

#!/usr/bin/python
# -*- coding: utf-8 -*-
# This file is part of FSE 2018.
#
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
"""Interface to Analog to Digital Converters."""
import sys
from os.path import dirname
sys.path.append(dirname(__file__))

import time
import spidev


class AnalogToDigitalConverter():
    """Class to represent MCP3008 analog to digital Converter"""
    # Voltage dividers 1kOhm/1kOhm (channel 0-3) - 22kOhm/10kOhm(channel 4-7)
    _facCh0123 = 2
    _facCh4567 = 3.195
    # Bytes for building read commands
    start_byte = 0x01
    channel_modifier = 0x08
    end_byte = 0x00

    def __init__(self):
        self._spi = spidev.SpiDev()
        self._spi.open(0, 0)
        self._spi.max_speed_hz = 5000000

    def _build_read_command(self, channel):
        """
        Produce 3-byte read command.
        The command is 1 byte, book-ended by start and end signifiers.
        """
        return [self.start_byte, (self.channel_modifier + channel) << 4,
                self.end_byte]

    def _process_adc_value(self, channel, value):
        """Return result of processing analog to digital converter value."""
        if channel <= 3:
            coefficient = self._facCh0123
        else:
            coefficient = self._facCh4567
        return (((value[1] & 3) << 8) + value[2]) * 0.00322 * coefficient

    def read_adc(self, channel):
        """Read ADC channel."""
        assert 0 <= channel <= 7, "ADC number must be a value of 0-7!"
        r = self._spi.xfer2(self._build_read_command(channel))
        return self._process_adc_value(channel, r)

    def __enter__(self):
        return self

    def __exit__(self, *args):
        self._spi.close()


if __name__ == '__main__':
    with AnalogToDigitalConverter() as adc:
        print('Reading MCP3008 values, press Ctrl-C to quit...')
        print('| {0:>4} | {1:>4} | {2:>4} | {3:>4} | {4:>4} | {5:>4} | {6:>4} |{7:>4} |'.format(*range(8)))
        print('-' * 57)

        while True:
            values = [0]*8
            for i in range(8):
                values[i] = round(adc.read_adc(i),2)

            print('| {0:>4} | {1:>4} | {2:>4} | {3:>4} | {4:>4} | {5:>4} | {6:>4} | {7:>4} |'.format(*values))
            time.sleep(0.5)
