freaf87/FSEDevBoard/(commit log)

2018-12-12 simplify LED interface a bit
2018-12-12 Ultrasonic module added
2018-12-12 Fix missing GND connection to PushButton
    [REV_B.kicad_pcb, REV_B.sch]
2018-12-13 buzzer, mcp3008, ultrasonic, pca9685 and rgb interfaces added
    [buzzer.py, mcp3008.py, pca9685.py, rgbLed.py, ultrasonicRanger.py]
2018-12-14 Made /drivers python3 compatible
2018-12-15 Add buzzer support to PDC.py
    [PDC.py]
2018-12-15 restructure a bit
    [REV_B_Order.ods]
2018-12-21 drivers made configurable
2019-01-04 change buzzer pin to GPIO4
    [PDC.py, buzzer.py]
2019-01-05 Motor driver tested ok
2019-07-07 LCD1602 and Rotary encoder support
